acamilo/b-parasite-long/(commit log)

2024-01-27 Created a new board definition for long variant
2024-01-28 Add code for 2 additional sensors
2024-01-28 wrangled device tree to add 2 more ADC channels
2024-01-28 Update Schematic to add 2 more sense points
    [parasite.kicad_sch]
2024-01-28 updated PCB with 3 zones and soil temp sensor
    [parasite.kicad_pcb, parasite.kicad_sch]
2024-01-28 added lcsc part numbers and a temp sensor
    [parasite.kicad_pcb, parasite.kicad_sch]
2024-02-29 Update encoding.c
    Fix error in array index
    [encoding.c]
2024-02-29 Add TMP117 temp sensor
2024-02-29 Fixed i2c address pin issue
    Connected pin to 3v to program 0x49 address
    [parasite.csv, parasite.kicad_pcb, parasite.kicad_sch]
